dyknapp/-ion-optics-hv/hardware/kicad/Eurocard-HV-piezo-driver.kicad_pcb

## KiCad design hardware/kicad/Eurocard-HV-piezo-driver.kicad_pcb (2026-10-25)

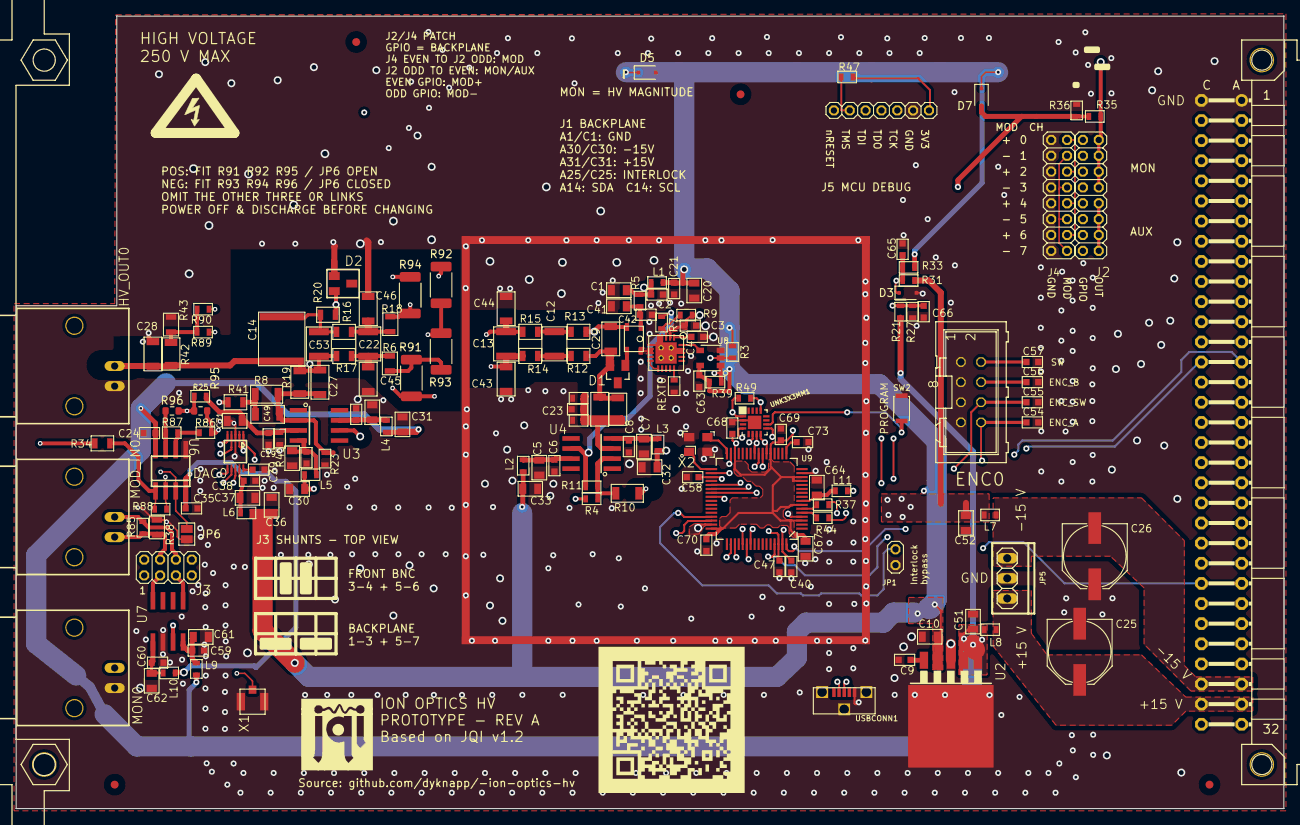
[picture p1: board Eurocard-HV-piezo-driver.kicad_pcb from above]

Board: 4 copper layers, 160.0 x 100.0 mm, 172 parts (0 on the bottom side), 99 nets.

Parts:
C1, C5, C7, C10, C15, C17, C20, C30, C31, C32, C33, C36, C37, C41, C51, C52, C61, C62, C64, C67, C71: 10uF; C_MLCC_0805
C2, C3, C4, C6, C8, C16, C18, C21, C24, C35, C38, C39, C40, C42, C47, C54, C55, C56, C57, C58, C59, C60, C63, C65, C66, C68, C69, C70, C73: 100nF; C_MLCC_0603
C9: 470pF; C_MLCC_0603
C11: HV 22pF; C_MLCC_1206
C12, C13, C22, C53: HV 100nF; C_MLCC_1210
C14: HV 1uF; C_MLCC_2220
C19: 47nF; C_MLCC_0603
C23: 2.2nF; C_MLCC_0603
C25, C26: 220uF; PANASONIC_F
C27, C28, C29, C49: HV 1nF; C_MLCC_1206
C43, C44, C45, C46: HV 10nF; C_MLCC_1206
D1: DHVSD3004SSQ-7; SOT23
D2: AZ23C15-FDICT-ND; SOT-23
D3, D5, D7: Schottky; D_SOD-323F
DAC0: AD5663R; MSOP10
ENC0: PINHD-2X4-SHROUD; ML08
FID1, FID2, FID3, FID4: FIDUCIAL-1.0MM; FID_1.0MM
HV_OUT0: BNC-H; BNC90
J1: VG64C; VG64-CUTOUT
J2, J4: 2X8_LOW_PROFILE_JUMPER; 2X8_LOW_PROFILE_JUMPER_MATRIX
J3: 2X4_LOW_PROFILE_JUMPER; 2X4_LOW_PROFILE_JUMPER_MATRIX
J5: 1x7 2.00mm; 1X7_LOW_PROFILE
JP1: 1X2_LOW_PROFILE_JUMPER; 1X2_LOW_PROFILE
JP5: DNP; 1X03
JP6: MON_POL; SolderJumper-2_P1.3mm_Open_Pad1.0x1.5mm
L1, L2, L3, L4, L5, L6, L7, L8, L9, L10, L11: 1k @100MHz; L_FERRITE_0603
MOD_IN0: BNC-H; BNC90
MON0: BNC-H; BNC90
QR1: https://github.com/dyknapp/-ion-optics-hv; QR_Documentation
R3, R4, R7, R11, R27, R31, R35, R39, R47, R49, R85, R86, R87: 10k; R_0603
R5: 5.6R; R_0603
R6, R12, R13, R14, R15, R16, R17, R18: 499R; R_0805
R8, R19: 1M; R_1206
R9: 27.4k; R_0603
R10: 499k; R_1206
R20, R34, R38, R41: 49.9R; R_0805
R21: 200k; R_0603
R23, R25: 20.5k; R_0603
R33, R36: 3k; R_0603
R37, R44: 39R; R_0603
R42: 4.99M; R_1206
R43: 100k; R_0805
R45: 1M; R_0603
R88: 300k; R_0603
R89, R90: 100k; R_0603
R91, R92, R93, R94: 0R; R_2010_5025Metric
R95, R96: 0R; R_0603_1608Metric
REXT0: 10k; R_0603
RF_0A0, RF_0B0: 10k; R_0603
RF_SHIELD0: RF_36103505; 36103505-SHIELD
RI_0: 499k; R_1206
SW2: SWITCH-TACTILE; SWITCH-TACTILE-SMD
T1: ATB3225; ATB_TRANSFORMER
U1: DRV2700; S-PVQFN-N20
U2: MIC5209; TO263-5
U3, U4: LM7171; SO08$1
U6: OPA2172; SO08
U7: AD8421; SOIC-8
U8: 74AHCT1G02; SOT23-5
U9: MK20DX256VLH7; QFP50P1200X1200X160-64N
U$5: JQI_LOGO_NEGATIVE-SILKSCREEN@1
UNK3X3MM1: CURRENT_BOOTLOADER3X3MM; QFN50P300X300X100-17N
USBCONN1: MICRO-USB/1051330011; MICRO-USB_1051330011
X1: UMC
X2: 16MHz 7.2pF; CRYSTAL-3.2-2.5

Connections:
+5V: C10.P$1 (1), C20.P$1 (1), C21.P$1 (1), C33.P$1 (1), C36.P$1 (1), C63.P$1 (1), D5.1 (C), D7.1 (C), L1.P$1 (1), L2.P$1 (1), L6.P$2 (2), L11.P$2 (2), R3.P$2 (2), R33.P$2 (2), R39.P$1 (1), U2.4 (OUT), U8.P$5 (VCC)
+5V_UC: C64.P$2 (2), L11.P$1 (1), U9.8 (VREGIN)
+15V: C25.+, J1.A31, J1.C31, JP5.1, L8.P$1 (1)
-15V: C26.-, J1.A30, J1.C30, JP5.3, L7.P$1 (1)
/Eurocard-HV-piezo-driver_1/HV_FILTER_IN: R6.P$2 (2), R91.2, R93.2
/Eurocard-HV-piezo-driver_1/HV_PRE_FILTER_IN: C13.P$1 (1), C43.P$2 (2), R14.P$1 (1), R91.1, R94.1
/Eurocard-HV-piezo-driver_1/HV_PRE_RETURN_IN: C13.P$2 (2), C44.P$1 (1), R15.P$1 (1), R92.1, R93.1
/Eurocard-HV-piezo-driver_1/HV_RETURN_IN: R18.P$2 (2), R92.2, R94.2
/Eurocard-HV-piezo-driver_1/VDC_SET_INV: R87.P$1 (1), R96.1, U6.7 (OUT)
/Eurocard-HV-piezo-driver_1/VMON_NONINV: JP6.2 (B), R90.P$1 (1), U6.3 (+IN)
AUX_DAC: DAC0.2 (VOUTB), J2.P$10, J2.P$12, J2.P$14, J2.P$16, X1.P$1 (1)
BACKPLANE_MODIN_N: J3.P$1, J4.P$4, J4.P$8, J4.P$12, J4.P$16
BACKPLANE_MODIN_P: J3.P$7, J4.P$2, J4.P$6, J4.P$10, J4.P$14
DAC_CLR: DAC0.5 (CLR), U9.55 (D29/A18/SCL1)
DAC_CS: DAC0.6 (SYNC), U9.53 (D28/A17)
DAC_LDAC: DAC0.4 (LDAC), U9.54 (D27/A16)
D_N: R37.P$1 (1), USBCONN1.2 (D-)
D_P: R44.P$1 (1), USBCONN1.3 (D+)
EN: R3.P$1 (1), U8.P$2 (A), U9.46 (D9/RX2/PWM)
ENC_A: C54.P$1 (1), ENC0.8, U9.39 (D0/RX1/TOUCH)
ENC_B: C56.P$1 (1), ENC0.4, U9.64 (D5/PWM)
ENC_SW: C55.P$1 (1), ENC0.6, U9.40 (D1/TX1/TOUCH)
GND: C1.P$2 (2), C2.P$2 (2), C3.P$2 (2), C4.P$2 (2), C5.P$2 (2), C6.P$2 (2), C7.P$1 (1), C8.P$1 (1), C9.P$2 (2), C10.P$2 (2), C15.P$2 (2), C16.P$2 (2), C17.P$1 (1), C18.P$1 (1), C19.P$2 (2), C20.P$2 (2), C21.P$2 (2), C23.P$1 (1), C24.P$2 (2), C25.-, C26.+, C28.P$2 (2), C30.P$1 (1), C31.P$2 (2), C32.P$1 (1), C33.P$2 (2), C35.P$2 (2), C36.P$2 (2), C37.P$2 (2), C38.P$2 (2), C39.P$2 (2), C40.P$2 (2), C41.P$1 (1), C42.P$1 (1), C43.P$1 (1), C44.P$2 (2), C45.P$1 (1), C46.P$2 (2), C47.P$2 (2), C51.P$2 (2), C52.P$2 (2), C54.P$2 (2), C55.P$2 (2), C56.P$2 (2), C57.P$2 (2), C58.P$2 (2), C59.P$2 (2), C60.P$2 (2), C61.P$2 (2), C62.P$2 (2), C63.P$2 (2), C64.P$1 (1), C65.P$2 (2), C66.P$2 (2), C67.P$1 (1), C68.P$1 (1), C69.P$1 (1), C70.P$1 (1), C71.P$2 (2), C73.P$1 (1), D2.1, D3.2 (A), D5.2 (A), DAC0.3 (GND), ENC0.1, ENC0.3, ENC0.5, ENC0.7, HV_OUT0.2, J1.A1, J1.C1, J4.P$1, J4.P$3, J4.P$5, J4.P$7, J4.P$9, J4.P$11, J4.P$13, J4.P$15, J5.P$2 (2), JP1.2, JP5.2, JP6.1 (A), MON0.2, R23.P$1 (1), R27.P$1 (1), R36.P$1 (1), R38.P$1 (1), R43.P$1 (1), R45.P$1 (1), REXT0.P$1 (1), RF_0A0.P$2 (2), RF_0B0.P$2 (2), RF_SHIELD0.P$1 (GND), RF_SHIELD0.P$2 (GND), RF_SHIELD0.P$3 (GND), RF_SHIELD0.P$4 (GND), SW2.1, U1.4 (GND), U1.5 (GND), U1.6 (GND), U1.18 (GAIN0), U1.19 (GAIN1), U1.PAD (GND), U1.V1 (GND), U1.V2 (GND), U1.V3 (GND), U1.V4 (GND), U2.3 (GND), U2.6 (GND), U6.5 (+IN), U7.6 (REF), U8.P$3 (GND), U9.4 (VSS), U9.15 (VREF-L), U9.31 (VSS), U9.47 (VSS), UNK3X3MM1.2 (GND), UNK3X3MM1.17 (GND), USBCONN1.5 (GND), USBCONN1.P$1 (GND), USBCONN1.P$2 (GND), USBCONN1.P$3 (GND), X1.P$2 (2), X1.P$3 (2), X2.2 (GND), X2.4 (GND)
GND_0: C29.P$2 (2), R10.P$1 (1), R13.P$2 (2), T1.1
GPIO_0: J1.A3, J2.P$1
GPIO_1: J1.C3, J2.P$3
GPIO_2: J1.A4, J2.P$5
GPIO_3: J1.C4, J2.P$7
GPIO_4: J1.A6, J2.P$9
GPIO_5: J1.C6, J2.P$11
GPIO_6: J1.A7, J2.P$13
GPIO_7: J1.C7, J2.P$15
HV: C14.P$1 (1), C27.P$2 (2), C28.P$1 (1), C53.P$1 (1), HV_OUT0.1, R17.P$1 (1), R19.P$2 (2), R42.P$2 (2)
HV_0: C11.P$2 (2), C29.P$1 (1), D1.2 (C), R12.P$2 (2), RI_0.P$1 (1)
HV_INTERLOCK: J1.A25, J1.C25, JP1.1, R39.P$2 (2), U8.P$1 (B), U9.45 (D23/A9/PWM/TOUCH)
HV_MIDGND: C14.P$2 (2), C53.P$2 (2), R16.P$1 (1), R20.P$1 (1)
I2C_SCL: J1.C14, U9.37 (D19/A5/SCL0/TOUCH)
I2C_SDA: J1.A14, U9.38 (D18/A4/SDA0/TOUCH)
JTAG_TCLK/SWD_KLK/EZP_CLK: J5.P$3 (3), U9.22 (PTA0), UNK3X3MM1.8 (PTB0)
JTAG_TDI/EZP_DI: J5.P$5 (5), U9.23 (PTA1), UNK3X3MM1.6 (PTA6)
JTAG_TDO/TRACE_SWO/EZP_DO: J5.P$4 (4), U9.24 (PTA2), UNK3X3MM1.9 (PTB1)
JTAG_TMS/SWD_DIO: J5.P$6 (6), R47.P$2 (2), U9.25 (PTA3), UNK3X3MM1.7 (PTA7)
MOSI: DAC0.8 (DATA), U9.51 (D11/MOSI)
unnamed: C4.P$1 (1), U1.1 (PUMP)
unnamed: C5.P$1 (1), C6.P$1 (1), L2.P$2 (2), U4.7 (V+)
unnamed: C7.P$2 (2), C8.P$2 (2), L3.P$2 (2), U4.4 (V-)
unnamed: C9.P$1 (1), U2.5 (FB)
unnamed: C11.P$1 (1), C23.P$2 (2), RF_0A0.P$1 (1), RF_0B0.P$1 (1), RI_0.P$2 (2), U4.3 (+IN)
unnamed: C12.P$1 (1), R12.P$1 (1), R14.P$2 (2)
unnamed: C12.P$2 (2), R13.P$1 (1), R15.P$2 (2)
unnamed: C15.P$1 (1), C16.P$1 (1), L4.P$2 (2), U3.7 (V+)
unnamed: C17.P$2 (2), C18.P$2 (2), L5.P$2 (2), U3.4 (V-)
unnamed: C22.P$1 (1), C45.P$2 (2), R6.P$1 (1), R17.P$2 (2)
unnamed: C22.P$2 (2), C46.P$1 (1), R16.P$2 (2), R18.P$1 (1)
unnamed: C27.P$1 (1), C49.P$2 (2), R8.P$2 (2), R19.P$1 (1), R23.P$2 (2), U3.2 (-IN)
unnamed: C37.P$1 (1), C38.P$1 (1), DAC0.9 (VDD), L6.P$1 (1)
unnamed: C39.P$1 (1), DAC0.10 (VREF)
unnamed: C41.P$2 (2), C42.P$2 (2), R5.P$1 (1), T1.2
unnamed: C49.P$1 (1), R8.P$1 (1), R41.P$2 (2)
unnamed: C59.P$1 (1), C61.P$1 (1), L9.P$1 (1), U7.8 (+VS)
unnamed: C60.P$1 (1), C62.P$1 (1), L10.P$1 (1), U7.5 (-VS)
unnamed: C73.P$2 (2), U9.17 (VREF_OUT)
unnamed: D1.1 (A), T1.4
unnamed: D2.2, R20.P$2 (2), U3.6 (OUT)
unnamed: R4.P$1 (1), R10.P$2 (2), R11.P$1 (1), U4.2 (-IN)
unnamed: R7.P$2 (2), R11.P$2 (2), U4.6 (OUT)
unnamed: R34.P$1 (1), R88.P$1 (1), U6.1 (OUT)
unnamed: J3.P$4, MOD_IN0.2, R38.P$2 (2), R85.P$1 (1)
unnamed: R41.P$1 (1), U7.7 (VOUT)
unnamed: J3.P$6, MOD_IN0.1, R85.P$2 (2)
unnamed: R86.P$1 (1), R87.P$2 (2), U6.6 (-IN)
unnamed: R88.P$2 (2), R89.P$1 (1), U6.2 (-IN)
unnamed: T1.3, U1.7 (SW), U1.8 (SW)
unnamed: U1.10 (BST), U1.11 (BST)
unnamed: U1.20 (EN), U8.P$4 (Y)
unnamed: J3.P$3, U7.4 (IN+)
unnamed: J3.P$5, U7.1 (IN-)
unnamed: U9.32 (OSC1), X2.3 (C2)
unnamed: U9.33 (OSC2), X2.1 (C1)
PROGRAM_PUSHBUTTON: SW2.2, UNK3X3MM1.10 (PTB2)
REXT+: REXT0.P$2 (2), U1.15 (REXT)
SCK: DAC0.7 (CLK), U9.50 (D13/SCK/LED)
SW: C57.P$1 (1), ENC0.2, U9.61 (D6/PWM)
TEENSY_RESET: J5.P$7 (7), R49.P$2 (2), U9.34 (RESET), UNK3X3MM1.4 (PTA4), UNK3X3MM1.13 (PTB5)
TEENSY_VCC: C67.P$2 (2), C68.P$2 (2), C69.P$2 (2), C70.P$2 (2), J5.P$1 (1), R47.P$1 (1), R49.P$1 (1), U9.3 (VCC), U9.7 (VOUT3V3), U9.13 (VCCA), U9.14 (VREF-H), U9.21 (VBAT), U9.30 (VCC), U9.48 (VCC), UNK3X3MM1.1 (VDD)
USB_N: R37.P$2 (2), U9.6 (USB-M)
USB_P: R44.P$2 (2), U9.5 (USB-P)
V+: C24.P$1 (1), C31.P$1 (1), C51.P$1 (1), L4.P$1 (1), L8.P$2 (2), L9.P$2 (2), R21.P$2 (2), U2.1 (EN), U2.2 (IN), U6.8 (V+)
V+MON: C40.P$1 (1), C66.P$1 (1), R21.P$1 (1), R27.P$2 (2), U9.63 (D21/A7/PWM)
V-: C30.P$2 (2), C32.P$2 (2), C35.P$1 (1), C52.P$1 (1), L3.P$1 (1), L5.P$1 (1), L7.P$2 (2), L10.P$2 (2), R31.P$1 (1), U6.4 (V-)
V-MON: C47.P$1 (1), C65.P$1 (1), D3.1 (C), R31.P$2 (2), R33.P$1 (1), U9.62 (D20/A6/PWM)
VDC_FILT: C19.P$1 (1), C71.P$1 (1), R25.P$1 (1), R45.P$2 (2), U3.3 (+IN)
VDC_SET: DAC0.1 (VOUTA), R4.P$2 (2), R86.P$2 (2), R95.1
VDC_SET_POL_SLCTD: R25.P$2 (2), R95.2, R96.2
VDD_CONVERTER: C1.P$1 (1), C2.P$1 (1), C3.P$1 (1), L1.P$2 (2), R5.P$2 (2), R9.P$1 (1), U1.2 (VDD)
VMON: R42.P$1 (1), R43.P$2 (2), R89.P$2 (2), R90.P$2 (2)
VMON_BUF: J2.P$2, J2.P$4, J2.P$6, J2.P$8, MON0.1, R34.P$2 (2), R35.P$2 (2)
VMON_MON: C58.P$1 (1), D7.2 (A), R35.P$1 (1), R36.P$2 (2), U9.35 (D16/A2/TOUCH)
V_FB: R7.P$1 (1), R9.P$2 (2), U1.3 (FB)
