dyknapp/-ion-optics-hv/(commit log)

2026-10-25 Add KiCad ion-optics prototype with manual HV polarity
    Place the reviewed six-sheet KiCad design and local libraries under
    hardware/kicad, preserving upstream Eagle files, firmware and history.
    Record the manual polarity, quench/LCD removal, part substitutions and
    remaining validation/firmware work in signed derivative documentation.
    Ignore KiCad local state and generated scratch output without hiding
    curated BOMs; normalize new CAD source whitespace for portable Git use.
    Leave the derivative URL and QR update pending the GitHub origin setup.
    Validation: all 55 CAD/library files preserve the reviewed source after
    formatting normalization. Native KiCad 10.0.7 reproduces 170 components,
    171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
    [Eurocard-HV-piezo-driver.kicad_pcb, Eurocard-HV-piezo-driver.kicad_sch, Eurocard-HV-piezo-driver_2.kicad_sch, Eurocard-HV-piezo-driver_3.kicad_sch, Eurocard-HV-piezo-driver_4.kicad_sch, Eurocard-HV-piezo-driver_5.kicad_sch, Eurocard-HV-piezo-driver_6.kicad_sch]
2026-10-25 Add board QR code and source link to ion-optics repository
    Point the printed source URL and a new silkscreen-only QR footprint to
    https://github.com/dyknapp/-ion-optics-hv. Preserve JQI attribution and
    record the published Documentation Location in the signed project docs.
    Use Q error correction, 0.45 mm modules and a four-module quiet border
    in an 18.45 mm square below the exposed RF-shield rim. Keep the artwork
    board-only and excluded from BOM/placement files; add its local library.
    Validation: decode the mask-subtracted silkscreen plot at three sizes to
    the exact URL. All existing electrical geometry/footprints are unchanged.
    DRC remains 557, schematic parity 137 and unconnected items z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
    [Eurocard-HV-piezo-driver.kicad_pcb]
